zetapersei/SI4684-DAB-Modular-Receiver/DAB_Module-Kicad/Dab_bom.xlsx

Comment | Designator | Footprint | JLCPCB Part#
33p | C1 | Capacitor_SMD:C_0402_1005Metric | C1562
2p7 | C2 | Capacitor_SMD:C_0603_1608Metric | C1650
22uF | C3,C4 | Capacitor_SMD:C_0603_1608Metric | C59461
1u | C5,C9,C10,C15,C18,C21 | Capacitor_SMD:C_0402_1005Metric | C52923
100nF | C6 | Capacitor_SMD:C_0402_1005Metric | C1525
2n2 | C7,C14,C17,C20 | Capacitor_SMD:C_0603_1608Metric | C1604
8pF | C8,C13,C16,C19 | Capacitor_SMD:C_0402_1005Metric | C1578
10u | C11,C12 | Capacitor_SMD:C_0603_1608Metric | C96446
BAV99 | D1 | Package_TO_SOT_SMD:SOT-23 | C2500
18nH | L1,L4 | Inductor_SMD:L_0402_1005Metric | C86060
120nH | L2 | Inductor_SMD:L_0402_1005Metric | C405042
22nH | L3 | Inductor_SMD:L_0402_1005Metric | C15178
10k | R1,R2 | Resistor_SMD:R_0402_1005Metric | C25744
100 | R3,R4,R5,R6 | Resistor_SMD:R_0402_1005Metric | C25076
AMS1117-3.3 | U2 | Package_TO_SOT_SMD:SOT-223-3_TabPin2 | C6186
MIC5504-1.8YM5 | U3 | Package_TO_SOT_SMD:SOT-23-5 | C626116
19.2Mhz | Y1 | Crystal:Crystal_SMD_3225-4Pin_3.2x2.5mm | C654977
