zetapersei/SI4684-DAB-Modular-Receiver/DAB_Module-Kicad/Dab+.csv

Reference | Value | Footprint | LCSC
C1 | 33p | Capacitor_SMD:C_0402_1005Metric | C1562
C2 | 2p7 | Capacitor_SMD:C_0603_1608Metric | C1650
C3,C4 | 22uF | Capacitor_SMD:C_0603_1608Metric | C59461
C5,C9,C10,C15,C18,C21 | 1u | Capacitor_SMD:C_0402_1005Metric | C52923
C6 | 100nF | Capacitor_SMD:C_0402_1005Metric | C1525
C7,C14,C17,C20 | 2n2 | Capacitor_SMD:C_0603_1608Metric | C1604
C8,C13,C16,C19 | 8pF | Capacitor_SMD:C_0402_1005Metric | C1578
C11,C12 | 10u | Capacitor_SMD:C_0603_1608Metric | C96446
D1 | BAV99 | Package_TO_SOT_SMD:SOT-23 | C2500
J1,J2 | Conn_01x20 | Connector_PinHeader_2.54mm:PinHeader_1x20_P2.54mm_Vertical
L1,L4 | 18nH | Inductor_SMD:L_0402_1005Metric | C86060
L2 | 120nH | Inductor_SMD:L_0402_1005Metric | C405042
L3 | 22nH | Inductor_SMD:L_0402_1005Metric | C15178
R1,R2 | 10k | Resistor_SMD:R_0402_1005Metric | C25744
R3,R4,R5,R6 | 100 | Resistor_SMD:R_0402_1005Metric | C25076
U1 | Si4684-A10-GM | Package_DFN_QFN:QFN-48-1EP_7x7mm_P0.5mm_EP5.1x5.1mm
U2 | AMS1117-3.3 | Package_TO_SOT_SMD:SOT-223-3_TabPin2 | C6186
U3 | MIC5504-1.8YM5 | Package_TO_SOT_SMD:SOT-23-5 | C626116
X1 | KH-SMA-K513-G | SMA:SMA_Amphenol_901-143_Horizontal_modified
Y1 | 19.2Mhz | Crystal:Crystal_SMD_3225-4Pin_3.2x2.5mm | C654977
