zetapersei/SI4684-DAB-Modular-Receiver/DAB_Module-Kicad/schematic.pdf

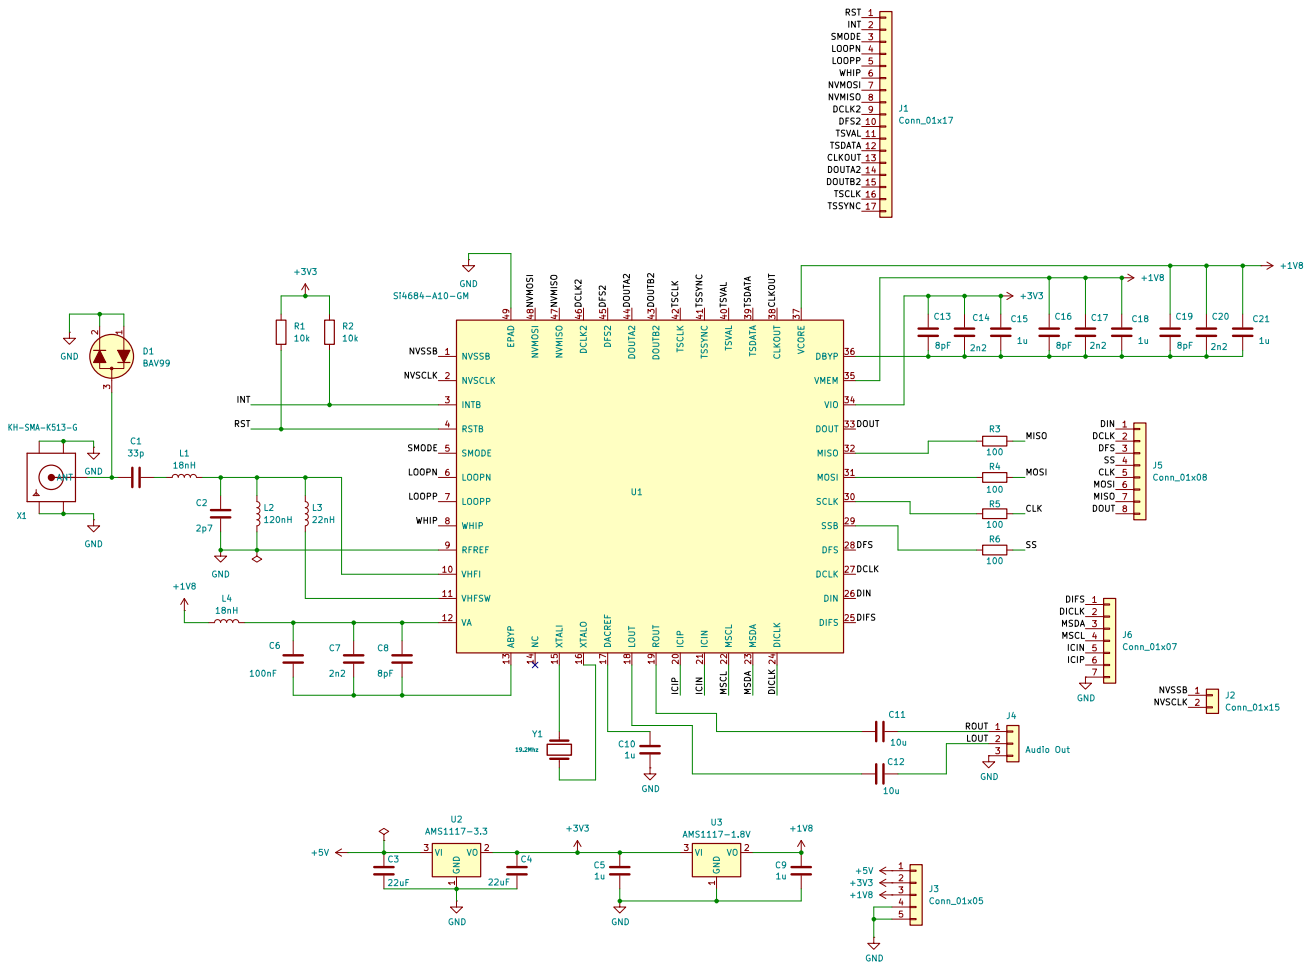
[picture p1: page 1]
