zetapersei/SI4684-DAB-Modular-Receiver/DAB_Module-Kicad/layout.pdf

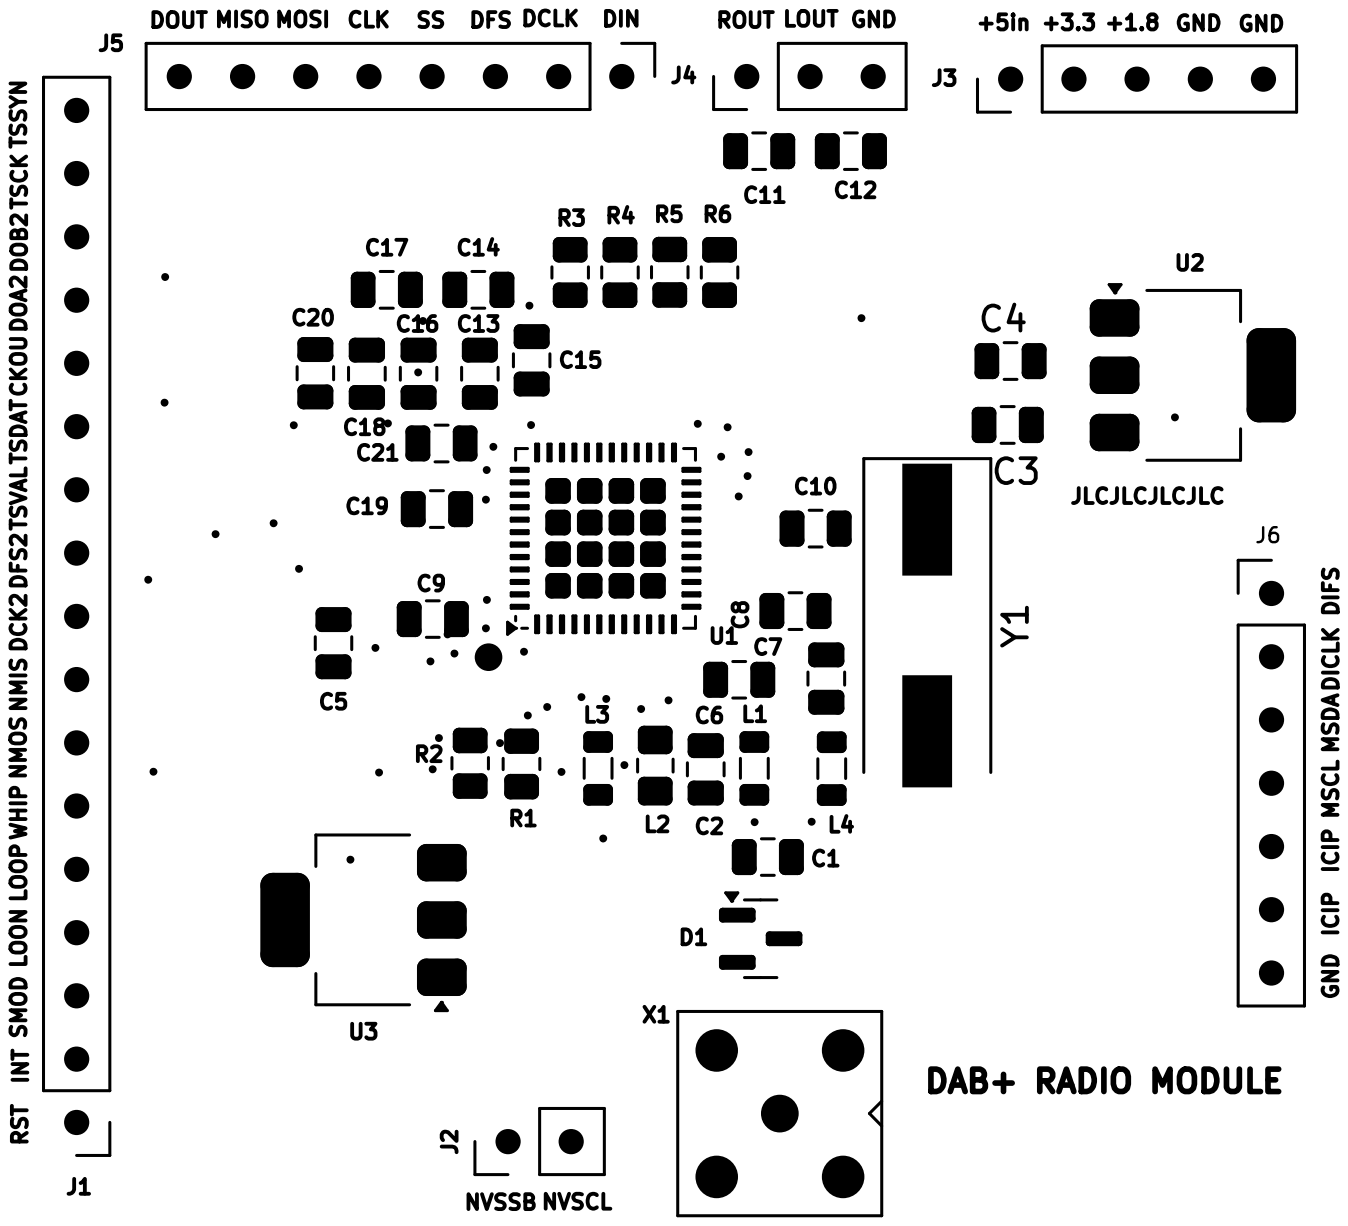
[picture p2: page 1]
