zetapersei/SI4684-DAB-Modular-Receiver/(list of files, drawings)

Other design files:
DAB_Module-Kicad/freerouting.dsn
DAB_Module-Kicad/temp-freerouting.dsn
