zetapersei/SI4684-DAB-Modular-Receiver/Controller-Kicad/SI4684 controller SMD.kicad_pcb

## KiCad design Controller-Kicad/SI4684 controller SMD.kicad_pcb (2026-11-07)

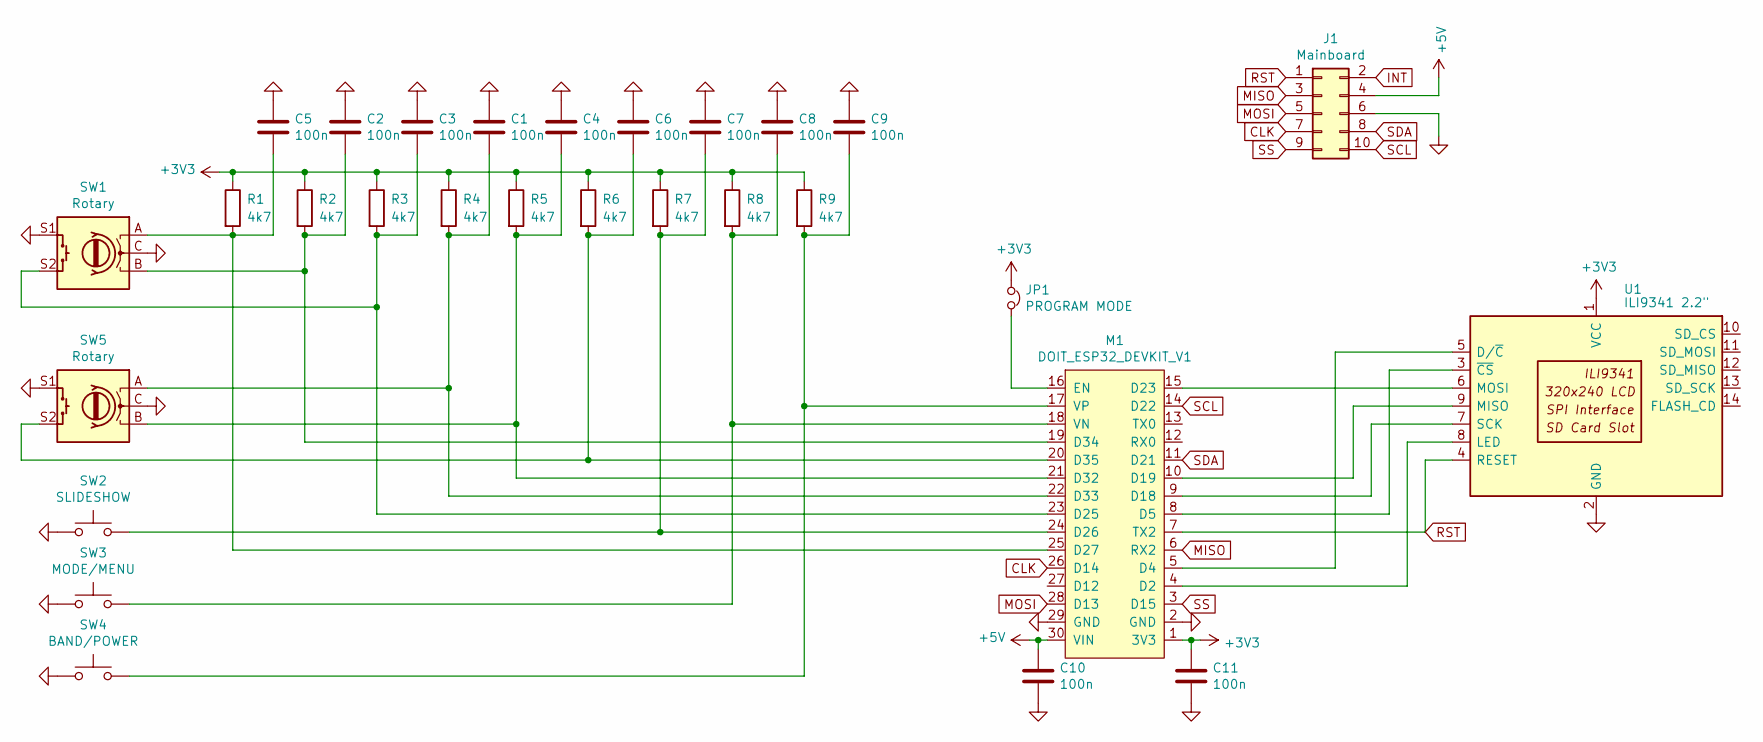
[picture p3: schematic SI4684 controller SMD.kicad_sch]

Parts:
C1, C2, C3, C4, C5, C6, C7, C8, C9, C10, C11: 100n; C_1206_3216Metric
J1: Mainboard; IDC-Header_2x05_P2.54mm_Vertical
JP1: PROGRAM MODE; TestPoint_2Pads_Pitch2.54mm_Drill0.8mm
M1: DOIT_ESP32_DEVKIT_V1; ESP32_DOIT_DEVKIT_V1
R1, R2, R3, R4, R5, R6, R7, R8, R9: 4k7; R_1206_3216Metric
SW1, SW5: Rotary; RotaryEncoder_Alps_EC11E-Switch_Vertical_H20mm
SW2: SLIDESHOW; SW_PUSH_6mm_H7.3mm
SW3: MODE/MENU; SW_PUSH_6mm_H7.3mm
SW4: BAND/POWER; SW_PUSH_6mm_H7.3mm
U1: ILI9341 2.2"; CR2013-MI2120

Connections:
+3V3: C11.1, JP1.1, M1.1 (3V3), R1.1, R2.1, R3.1, R4.1, R5.1, R6.1, R7.1, R8.1, R9.1, U1.1 (VCC)
+5V: C10.1, J1.4, M1.30 (VIN)
CLK: J1.7, M1.26 (D14)
GND: C1.1, C2.1, C3.1, C4.1, C5.1, C6.1, C7.1, C8.1, C9.1, C10.2, C11.2, J1.6, M1.2 (GND), M1.29 (GND), SW1.C, SW1.S1, SW2.1, SW3.1, SW4.1, SW5.C, SW5.S1, U1.2 (GND)
INT: J1.2
MISO: J1.3, M1.6 (RX2)
MOSI: J1.5, M1.28 (D13)
unnamed: M1.4 (D2), U1.8 (LED)
unnamed: M1.5 (D4), U1.5 (D/~C)
unnamed: M1.8 (D5), U1.3 (~CS)
unnamed: M1.9 (D18), U1.7 (SCK)
unnamed: M1.10 (D19), U1.9 (MISO)
unnamed: M1.15 (D23), U1.6 (MOSI)
unnamed: C3.2, M1.23 (D25), R3.2, SW1.S2
unnamed: C7.2, M1.24 (D26), R7.2, SW2.2
unnamed: C5.2, M1.25 (D27), R1.2, SW1.A
unnamed: C4.2, M1.21 (D32), R5.2, SW5.B
unnamed: C1.2, M1.22 (D33), R4.2, SW5.A
unnamed: C2.2, M1.19 (D34), R2.2, SW1.B
unnamed: C6.2, M1.20 (D35), R6.2, SW5.S2
unnamed: JP1.2, M1.16 (EN)
unnamed: C8.2, M1.18 (VN), R8.2, SW3.2
unnamed: C9.2, M1.17 (VP), R9.2, SW4.2
RST: J1.1, M1.7 (TX2), U1.4 (RESET)
SCL: J1.10, M1.14 (D22)
SDA: J1.8, M1.11 (D21)
SS: J1.9, M1.3 (D15)

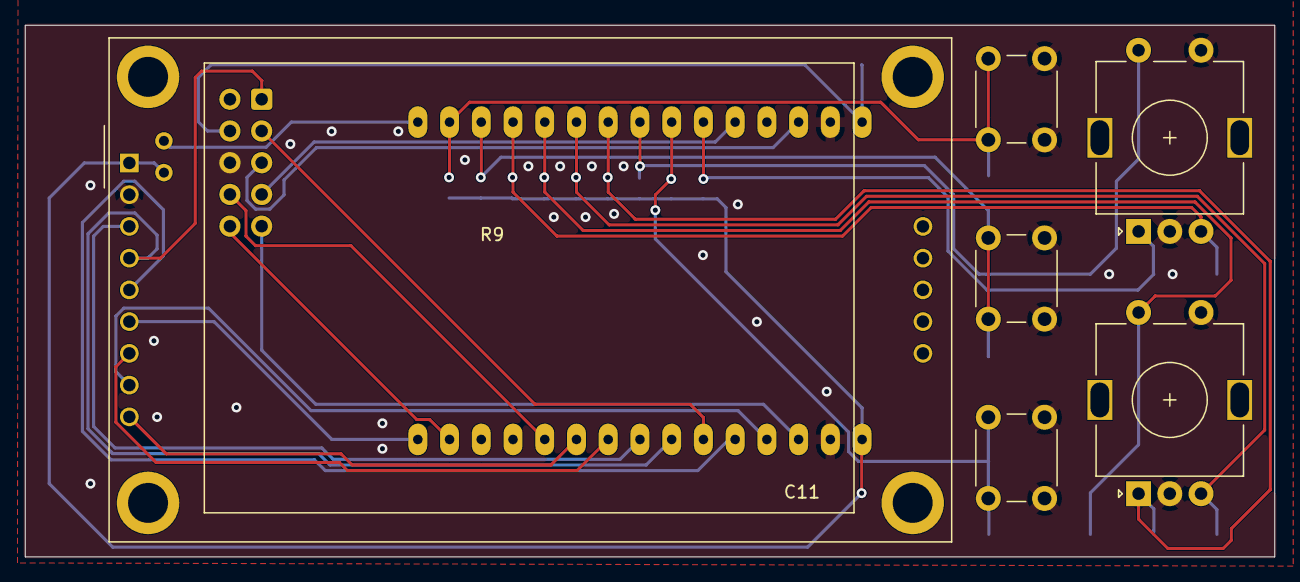
[picture p4: board SI4684 controller SMD.kicad_pcb from above]

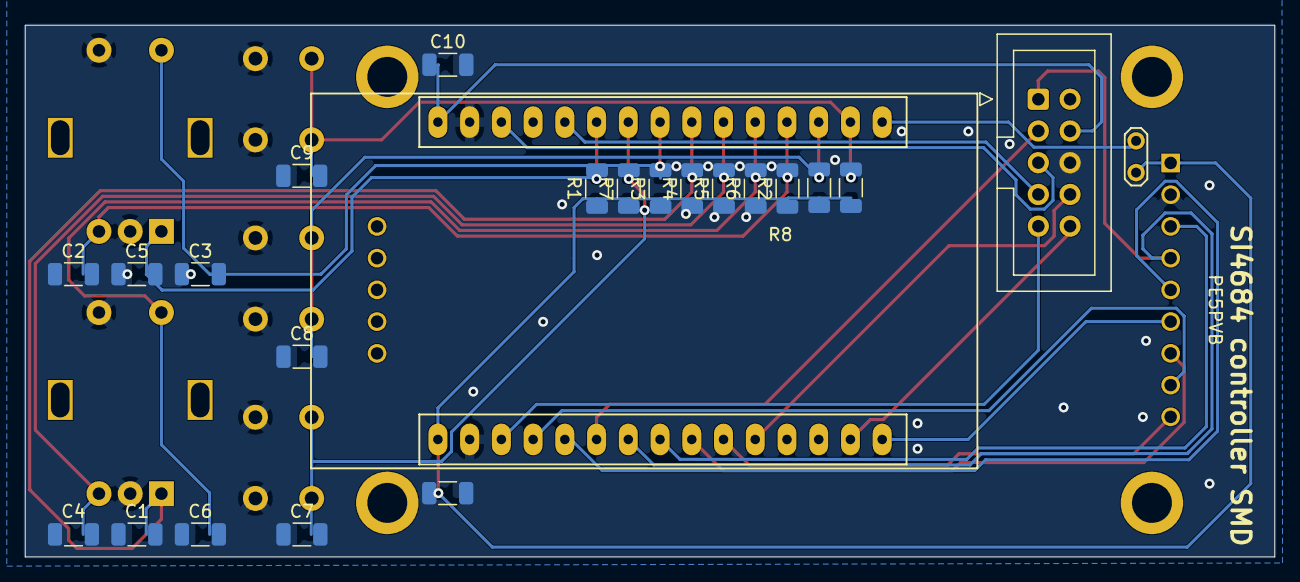
[picture p5: board SI4684 controller SMD.kicad_pcb from below]

Board: 2 copper layers, 100.0 x 42.5 mm, 29 parts (23 on the bottom side), 26 nets.
