zetapersei/SI4684-DAB-Modular-Receiver/DAB_Module-Kicad/Dab+.kicad_pcb

## KiCad design DAB_Module-Kicad/Dab+.kicad_pcb (2026-11-06)

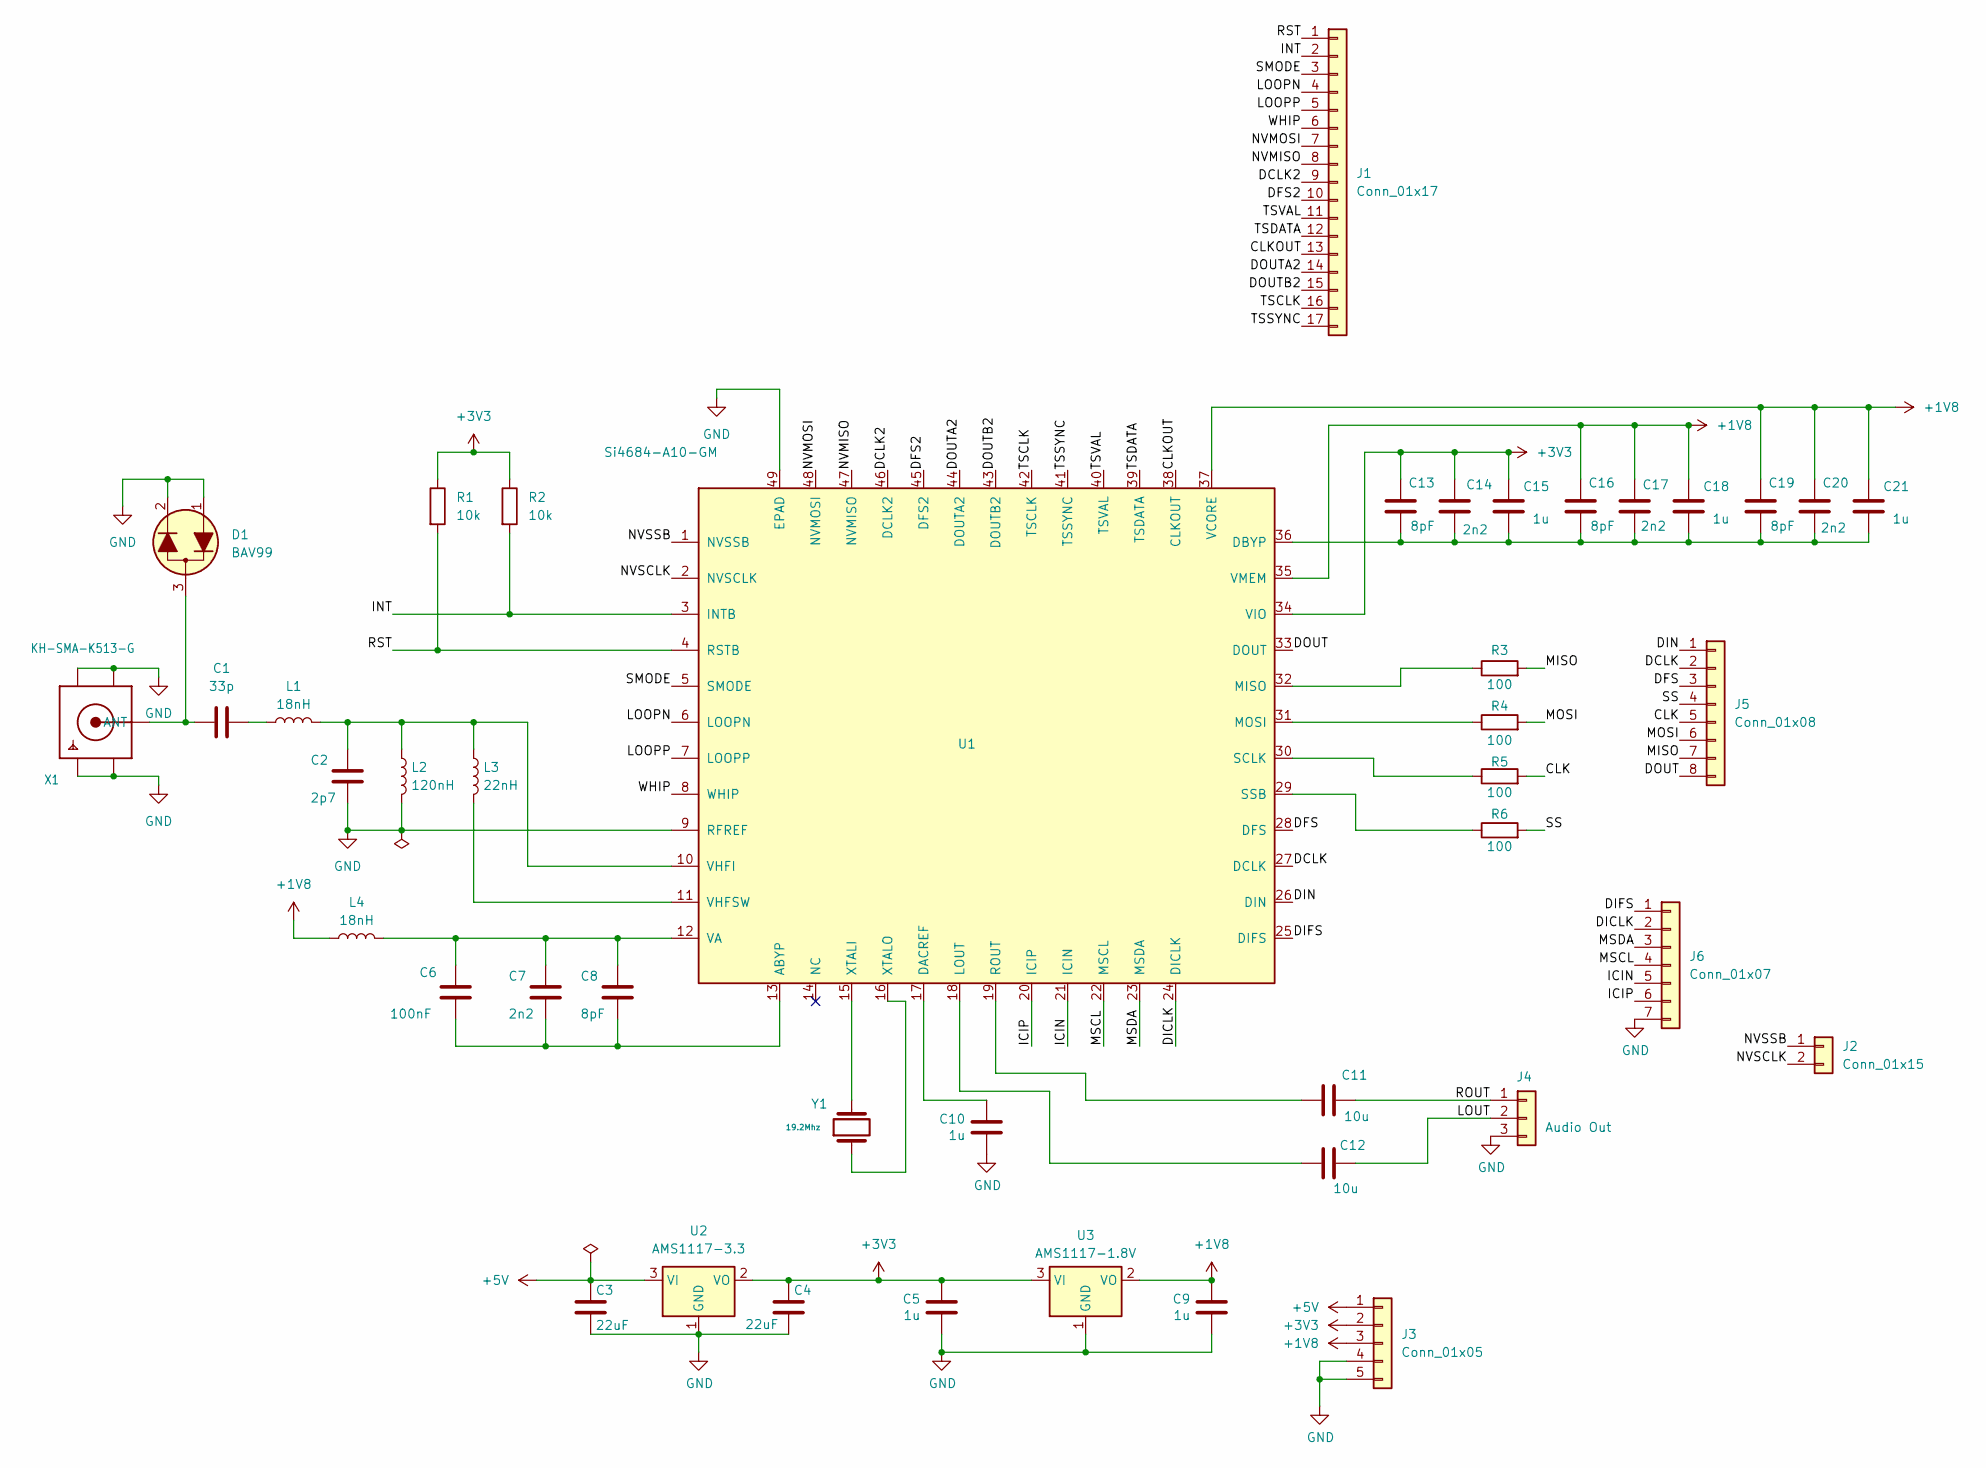
[picture p6: schematic Dab+.kicad_sch, DAB+ receiver module A]

Parts:
C1: 33p; C_0805_2012Metric; LCSC C1562
C2: 2p7; C_0805_2012Metric; LCSC C1650
C3, C4: 22uF; C_0805_2012Metric; LCSC C59461
C5, C9, C10, C15, C18, C21: 1u; C_0805_2012Metric; LCSC C52923
C6: 100nF; C_0805_2012Metric; LCSC C1525
C7, C14, C17, C20: 2n2; C_0805_2012Metric; LCSC C1604
C8, C13, C16, C19: 8pF; C_0805_2012Metric; LCSC C1578
C11, C12: 10u; C_0805_2012Metric; LCSC C96446
D1: BAV99; SOT-23; LCSC C2500
J1: Conn_01x17; PinHeader_1x17_P2.54mm_Vertical
J2: Conn_01x15; PinHeader_1x02_P2.54mm_Vertical
J3: Conn_01x05; PinHeader_1x05_P2.54mm_Vertical
J4: Audio Out; PinHeader_1x03_P2.54mm_Vertical
J5: Conn_01x08; PinHeader_1x08_P2.54mm_Vertical
J6: Conn_01x07; PinHeader_1x07_P2.54mm_Vertical
L1, L4: 18nH; L_0805_2012Metric; LCSC C86060
L2: 120nH; L_0805_2012Metric_Pad1.15x1.40mm_HandSolder; LCSC C405042
L3: 22nH; L_0805_2012Metric; LCSC C15178
R1, R2: 10k; R_0805_2012Metric; LCSC C25744
R3, R4, R5, R6: 100; R_0805_2012Metric; LCSC C25076
U1: Si4684-A10-GM; QFN-48-1EP_7x7mm_long_term
U2: AMS1117-3.3; SOT-223-3_TabPin2; LCSC C6186
U3: AMS1117-1.8V; SOT-223-3_TabPin2; LCSC C626116
X1: KH-SMA-K513-G; SMA_Amphenol_901-143_Horizontal_modified
Y1: 19.2Mhz; Crystal_SMD_HC49-SD; LCSC C654977

Connections:
+1V8: C9.1, C16.1, C17.1, C18.1, C19.1, C20.1, C21.1, J3.3, L4.1, U1.35 (VMEM), U1.37 (VCORE), U3.2 (VO)
+3V3: C4.1, C5.1, C13.1, C14.1, C15.1, J3.2, R1.1, R2.1, U1.34 (VIO), U2.2 (VO), U3.3 (VI)
+5V: C3.1, J3.1, U2.3 (VI)
/CLK: J5.5, R5.2
/CLKOUT: J1.13, U1.38 (CLKOUT)
/DCLK: J5.2, U1.27 (DCLK)
/DCLK2: J1.9, U1.46 (DCLK2)
/DFS: J5.3, U1.28 (DFS)
/DFS2: J1.10, U1.45 (DFS2)
/DICLK: J6.2, U1.24 (DICLK)
/DIFS: J6.1, U1.25 (DIFS)
/DIN: J5.1, U1.26 (DIN)
/DOUT: J5.8, U1.33 (DOUT)
/DOUTA2: J1.14, U1.44 (DOUTA2)
/DOUTB2: J1.15, U1.43 (DOUTB2)
/ICIN: J6.5, U1.21 (ICIN)
/ICIP: J6.6, U1.20 (ICIP)
/INT: J1.2, R2.2, U1.3 (INTB)
/LOOPN: J1.4, U1.6 (LOOPN)
/LOOPP: J1.5, U1.7 (LOOPP)
/LOUT: C12.2, J4.2
/MISO: J5.7, R3.2
/MOSI: J5.6, R4.2
/MSCL: J6.4, U1.22 (MSCL)
/MSDA: J6.3, U1.23 (MSDA)
/NVMISO: J1.8, U1.47 (NVMISO)
/NVMOSI: J1.7, U1.48 (NVMOSI)
/NVSCLK: J2.2, U1.2 (NVSCLK)
/NVSSB: J2.1, U1.1 (NVSSB)
/ROUT: C11.2, J4.1
/RST: J1.1, R1.2, U1.4 (RSTB)
/SMODE: J1.3, U1.5 (SMODE)
/SS: J5.4, R6.2
/TSCLK: J1.16, U1.42 (TSCLK)
/TSDATA: J1.12, U1.39 (TSDATA)
/TSSYNC: J1.17, U1.41 (TSSYNC)
/TSVAL: J1.11, U1.40 (TSVAL)
/WHIP: J1.6, U1.8 (WHIP)
GND: C2.2, C3.2, C4.2, C5.2, C9.2, C10.2, D1.1 (A), D1.2 (K), J3.4, J3.5, J4.3, J6.7, L2.2, U1.9 (RFREF), U1.49 (EPAD), U2.1 (GND), U3.1 (GND), X1.2 (GND1)
unnamed: C1.2, L1.1
unnamed: C1.1, D1.3 (C), X1.1 (ANT)
unnamed: C6.1, C7.2, C8.2, U1.13 (ABYP)
unnamed: C10.1, U1.17 (DACREF)
unnamed: C13.2, C14.2, C15.2, C16.2, C17.2, C18.2, C19.2, C20.2, C21.2, U1.36 (DBYP)
unnamed: C12.1, U1.18 (LOUT)
unnamed: R3.1, U1.32 (MISO)
unnamed: R4.1, U1.31 (MOSI)
unnamed: C11.1, U1.19 (ROUT)
unnamed: R5.1, U1.30 (SCLK)
unnamed: R6.1, U1.29 (SSB)
unnamed: C6.2, C7.1, C8.1, L4.2, U1.12 (VA)
unnamed: C2.1, L1.2, L2.1, L3.1, U1.10 (VHFI)
unnamed: L3.2, U1.11 (VHFSW)
unnamed: U1.15 (XTALI), Y1.2
unnamed: U1.16 (XTALO), Y1.1

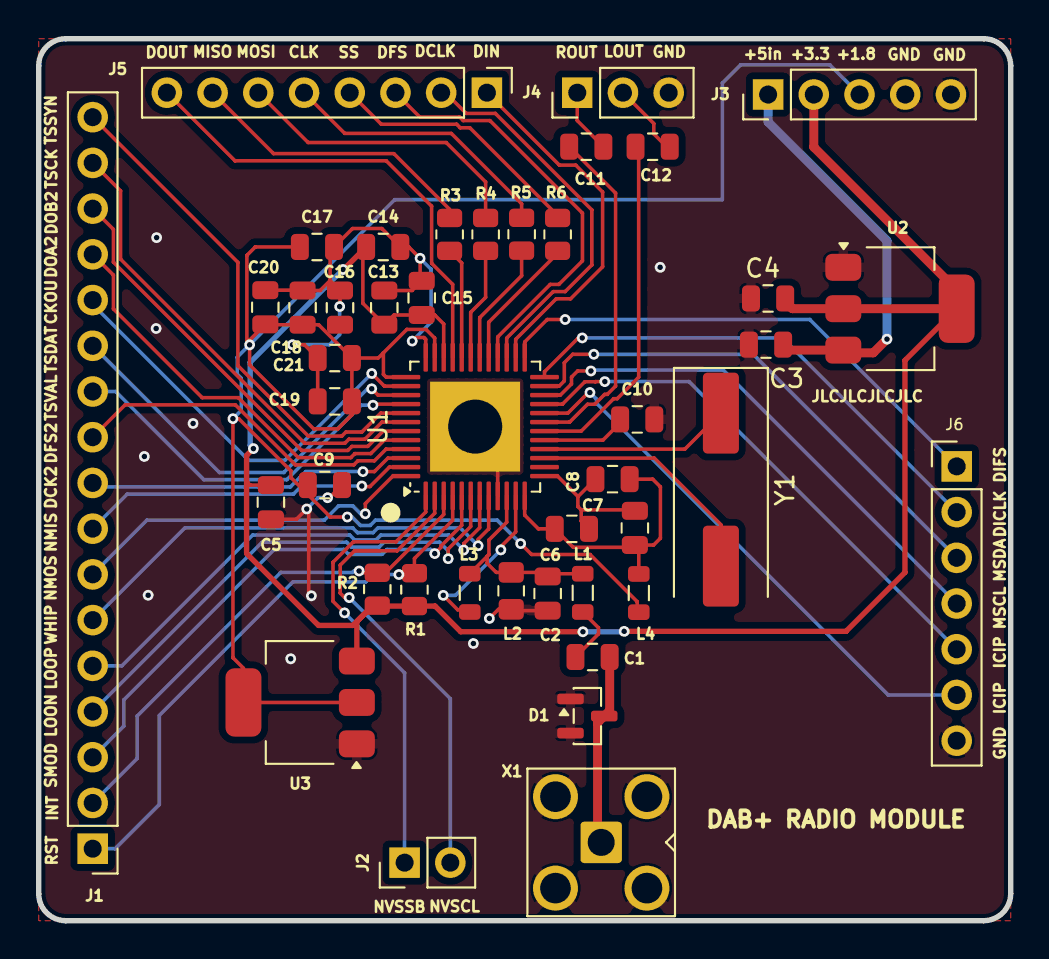
[picture p7: board Dab+.kicad_pcb from above]

Board: 2 copper layers, 54.0 x 49.0 mm, 43 parts (0 on the bottom side), 55 nets.
