zetapersei/SI4684-DAB-Modular-Receiver/(commit log)

2026-11-06 new file: .gitignore new file: .vscode/extensions.json new file: Kicad/BOM/2109100930_Microchip-Tech-MIC5504-1-8YM5-TR_C626116.pdf new file: Kicad/BOM/2304140030_Nexperia-BAV99-215_C2500.pdf new file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
    [Dab+.csv, Dab+.kicad_pcb, Dab+.kicad_sch, Dab_bom.xlsx, freerouting.dsn, temp-freerouting.dsn]
2026-11-07 new file: Controller-Kicad/ESP32_DOIT_DEVKIT_V1.kicad_mod new file: Controller-Kicad/Library.pretty/ESP32_DOIT_DEVKIT_V1.kicad_mod new file: Controller-Kicad/Library.pretty/ZJY_TFT400_11P_TOUCH.kicad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
    [Dab+.csv, Dab+.kicad_pcb, Dab+.kicad_sch, Dab_bom.xlsx, SI4684 controller SMD.kicad_pcb, SI4684 controller SMD.kicad_sch, freerouting.dsn, temp-freerouting.dsn]
2026-11-07 new file: Controller-Kicad/SI4684 controller SMD-backups/SI4684 controller SMD-2026-11-07_135157.zip new file: Controller-Kicad/SI4684 controller SMD-backups/SI4684 controller SMD-2026-11-07_135203.z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
    [SI4684 controller SMD.kicad_pcb, SI4684 controller SMD.kicad_sch]
