zetapersei/SI4684-DAB-Modular-Receiver/(notices)

Notices in the files:
README.md:
https://img.shields.io/badge/license%20-%20GNU_GPLv3-GPLv3?color=blue
